chGoodchild/ups_switch/simulations/README.txt

Adding parts to LTSpice: https://www.youtube.com/watch?v=ajcYYwoHF0g

Finally we are thinking about using the TIP122
