chGoodchild/ups_switch/documents/dt90_specification.jpg

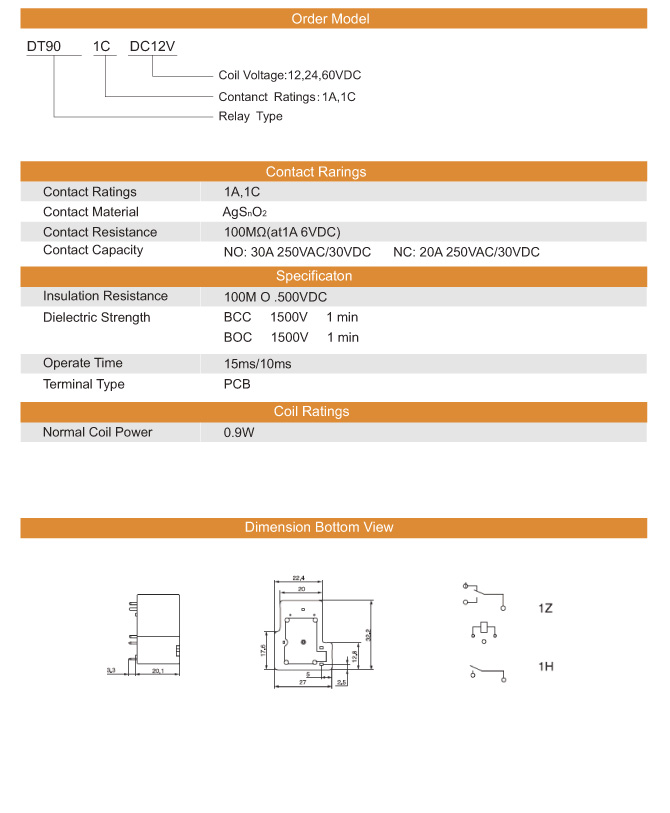
documents/dt90_specification.jpg
