chGoodchild/ups_switch/expenses.ods

Sheet: bill_materials
Common material |  |  |  |  |  | mod_switch_battery_voltage
Item | Model | Price | Qty. | Total | Comment | Item | Model | Price | Qty. | Total | Comment
Arduino Nano | Nano | 250 | 1 | 250 |  |  |  |  |  | 0
Resistors |  |  |  | 0 |  | Resistors |  | 1 | 4 | 4
 |  |  |  |  |  | Transistor | IRF540 | 25 | 1 | 25
 |  |  |  |  |  | Opto-isolator | PC817(B?) | 5 | 1 | 5
Headers | 3-pin |  |  | 0 |  | BrkWay Headers |  | 1 | 9 | 9
Headers | 2-pin |  |  | 0 |  | RMC Headers | 2-pin | 1 | 1 | 1
Headers | 15-pin |  | 0 | 0 | We don’t need to solder them on, only leave holes for them on the PCB, in case | LEDs |  | 2 | 1 | 2
 |  |  |  | 0 |  |  |  |  |  | 0
 |  |  |  | 0 |  |  |  |  |  | 0
 |  |  |  |  |  | Relay |  | 400 | 1 | 400
Diode | 1N4004 |  |  | 0 |  | Diode | 1N4004 | 1 | 2 | 2
Headers’ cables | 3-pin |  |  | 0 |  | Zener diode |  | 2 | 1 | 2
Headers’ cables | 2-pin |  |  | 0 |  | Headers’ cables | 2-pin | 10 | 1 | 10
 |  |  |  | 0 |  |  |  |  |  | 0
 |  |  |  | 0 |  |  |  |  |  | 0
 |  |  |  | 0 |  |  |  |  |  | 0
 |  |  |  | 0 |  |  |  |  |  | 0
 |  |  |  | 0 |  |  |  |  |  | 0
 |  |  |  | 0 |  |  |  |  |  | 0
 |  |  |  | 0 |  |  |  |  |  | 0
 |  |  |  | 0 |  |  |  |  |  | 0
PCB |  | 100 | 1 | 100 |  | PCB |  | 100 | 1 | 100
Soldering cost |  |  | 1 | 0 |  | Soldering cost |  | 75 | 1 | 75
Total |  |  |  | 350 |  | Total |  |  |  | 635
Total |  |  |  |  |  | Casing
Common material | 350 |  |  |  |  | Item | Model | Price | Qty. | Total | Comment
mod_switch_battery_voltage | 635 |  |  |  |  |  |  |  |  | 0
Casing | 64 |  |  |  |  |  |  |  |  | 0
Power supply part
Total | 1049 |  |  |  |  |  |  |  |  | 0
 |  |  |  |  |  |  |  |  |  | 0
 |  |  |  |  |  |  |  |  |  | 0
 |  |  |  |  |  | LEDs | Green? | 2 | 1 | 2
 |  |  |  |  |  | LEDs | Red? | 2 | 1 | 2
 |  |  |  |  |  |  |  |  |  | 0
 |  |  |  |  |  |  |  |  |  | 0
 |  |  |  |  |  |  |  |  |  | 0
 |  |  |  |  |  | Fuse holder | DC |  | 1 | 0
 |  |  |  |  |  | Battery cable set |  |  | 1 | 0
 |  |  |  |  |  | Switches |  |  |  | 0
 |  |  |  |  |  | Buttons |  |  |  | 0
 |  |  |  |  |  | 230 V AC socket |  |  | 1 | 0
 |  |  |  |  |  | 230 V AC plug |  | 60 | 1 | 60
 |  |  |  |  |  | 230 V AC power cord |  |  | 1 | 0
 |  |  |  |  |  | 230 V AC neon indicator? |  |  | 1 | 0
 |  |  |  |  |  |  |  |  |  | 0
 |  |  |  |  |  |  |  |  |  | 0
 |  |  |  |  |  | Total |  |  |  | 64

Sheet: shopping_list__bills
10K resistors |  | Bills |  | Dyuman | Chandran |  |  | Transfers |  |  | Debts
330 ohm resistors |  | A1-A11 | Naresh | ? |  |  |  | From | To | Amount | Chandran | Dyuman
4.7k resistors |  | A14,2xA16 | Naresh | 720 |  | 18/01/2018NA1 | Bill unmarked | Chandran | Dyuman | 800 | 970.105 | -970.105
100K resistors |  | A15,A19,A20 | Ganapathy | 90 |  |  |  | Chandran | Dyuman | 5201
1K resistors |  | 3xA16 | Universal | 750 |  | 18/01/2018UN1 | Bill unmarked | Chandran | Dyuman | 4500
diodes |  | 3xA24 | Naresh | 45 |  |  |  | Chandran | Dyuman (102659K - CARLA,SAURO DYUMAN) | 860
1.2M resistors |  | 10xA31 | Aurorica Circuits | 1000
2.2K resistors |  | 26/01/2018NA1 | Naresh | 467 |  | 26/01/2018NA1
2200p capacitor (ceramic) |  | A36 | Naresh | 45
100n capacitor (ceramic) |  | A39 | Sri Ganesh Kumaran Electricals |  | 174
22k resistors |  | A40 |  |  | 70
 |  | A32 | New Waves | 750
 |  | 3xA34 | Evelta | 669.1
schotkey diode |  | 10xA44 | Amazon | 715
opto isolator |  | 2xA16 | Naresh | 700 |  | 10/02/2018NA1
arduino |  | 2xA47 | eBay | 540
 |  | 2xA45 | Indica Computers | 340
opto isolator module |  | A47 | Deepak Electricals | 650
RS-232 connectors/cable/accessories |  | A48 | Suman Electricals | 230
560 ohm resistor |  | 100xA51:advance | Micro Track industries | 4000
IL2 9644J opto isolator |  | misc. Components between A53-A77 | Naresh | 495
breakaway header |  | 4xA55 | Ganapathy | 40
 |  | 10xA59 | eBay | 4000
IRF540 |  | 50xA57,50xA56 | RS components | 3142.93
resistor for above |  | A87 | eBay | 636 |  |  |  |  |  | 11361
Victor multimeter leads |  | A91 | Ganapathy
 |  | 1xA93,20xA53,10xA92 | Naresh | 170
Cordless phone batteries |  | A16 | Ganapathy |  | 380
Power bank |  | A84 | Kasthuri Emporium |  | 750
 |  | 100xA51:balance | Micro Track industries | 2490
PCB: mod_switch_battery_voltage |  | A85 |  |  | 25
Soldering: mod_switch_battery_voltage |  | A86 |  |  | 45
 |  | Main board soldering | New Waves |  | 1620
Current sensor |  | 2x5Vrelay | Ganapathy | 80
 |  | 230V coil 25A relay | Suman Electricals | 550
zener diode |  | 6x5V30Arelaymodules | eBay | 1618
RMC 2 pin |  | Heatsinks | Sun Electronics? |  | 220
 |  | fuses,fuseholders | Naresh |  | 97
Casing / 15A socket / buttons |  | 3xIRF540 | Universal | 80
Casing (box cutting) |  | 10x6Vrelay:advance | Naresh | 500
Phone repair? |  | 5x6Vrelay,8x9Vbattery,8x9Vbatcap | Ganapathy |  | 1150
Phone cover |  | Last School donation: CCTV camera |  | 1255
 |  | Last School donation: CCTV camera accessories |  | 55
DC-DC converter |  | Last School donation: 15A wall sockets |  | 422
USB cables |  | Voltage Regulators | RS components | 1948.18
Solid state relay + heatsink
Enclosure trial |  | Sub-total |  | 29193.21 | 4531
Enclosure trial |  | Sub-total (with transfers) |  | 17832.21 | 15892
 |  | Total |  |  | 33724.21
PCB: main_board
 |  | Expenses from before
RMC header 2-pin | 2 | DC-DC converter |  |  | Dyuman
RMC header 3-pin | 1 | Hot glue (1 stick)
breakaway header | 66
Fuse (F1) | 1
MCP1702 | 1
TIP122 | 1
display | 1 | Arduino list
arduino | 1 | 5 (18/01/2018NA1 and 18/01/2018UN1) | Chandran house | Burnt? | Breadboard | Class?
pushbutton | 3 | 2 (10/02/2018NA1) | LCD shield | Stored in desk
zener diode | 1 | 1 (found in clampmeter pouch, bought while before)
current sensor | 1
4.7k resistors | 1
330 ohm resistors | 1
Solid state relay + heatsink | 1
opto isolator | 1
44K resistor | 1
>10K | 1
C1 | 1
C2 | 1
capacitor (current sensor in) | 0
capacitor (current sensor out) | 0
Fuse (230 V, opto isolator) | 1
prototyping board | 0.1
RMC connectors 2-pin | 2
RMC connectors 3-pin | 1
battery cable (with lugs and fuse) | 1
fuse (battery cable) | 1
Casing | 1
mains socket/power cable/plug/screw terminals, depending on casing design | 1
circuit breaker for mains, or special fast acting fuse
Box
Notebook
Stapler
Solid state relay 100A
socket for arduino
opto isolator resistor divider
USB cable
drawers?
Heatsinks (with screws and washers/nuts)
Thermal paste
PCB: mains module
Relay | 1
Connector block | 4
Wire black/red
Diode 1N4004 | 2
PC817 | 1
IRF540 | 1
LM7805? | 1
47uF cap | 1
10uF cap | 1
breakaway header | 5
PC814 | 1
1.5M resistor | 1
10K? resistor (mosfet) | 1
6V zener? | 1
560? resistor (pc817) | 1
Lamp pwr adapters | 2

Sheet: Sheet3
Shops / Contacts
Aurorica | 9944956802
 | 9894025812
Interlogicx Solutions
PCB assembly services
Metro electronics | 9712336798
New waves | 9443090082
