chGoodchild/ups_switch/bat_tests/2019_06_12.png

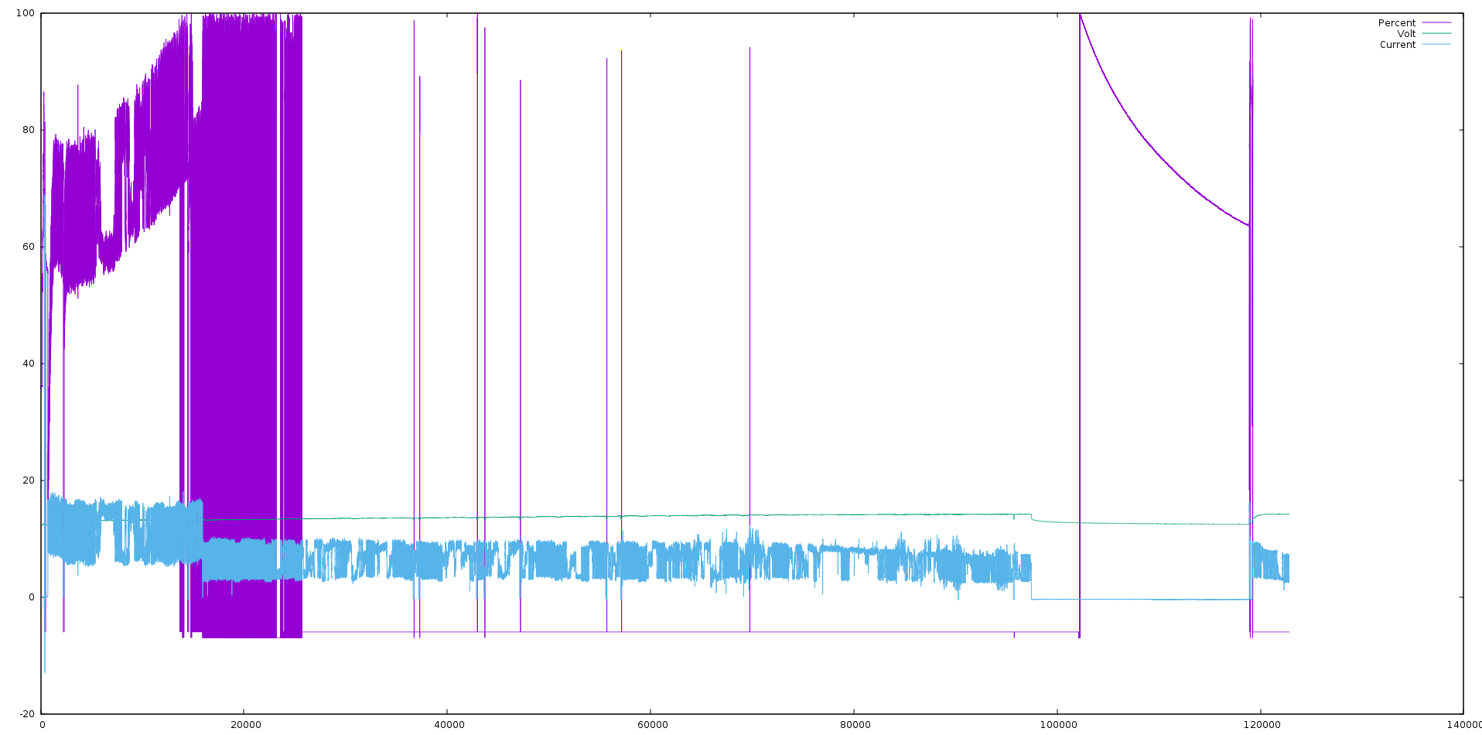
bat_tests/2019_06_12.png
