chGoodchild/ups_switch/bat_tests/2019_06_13.png

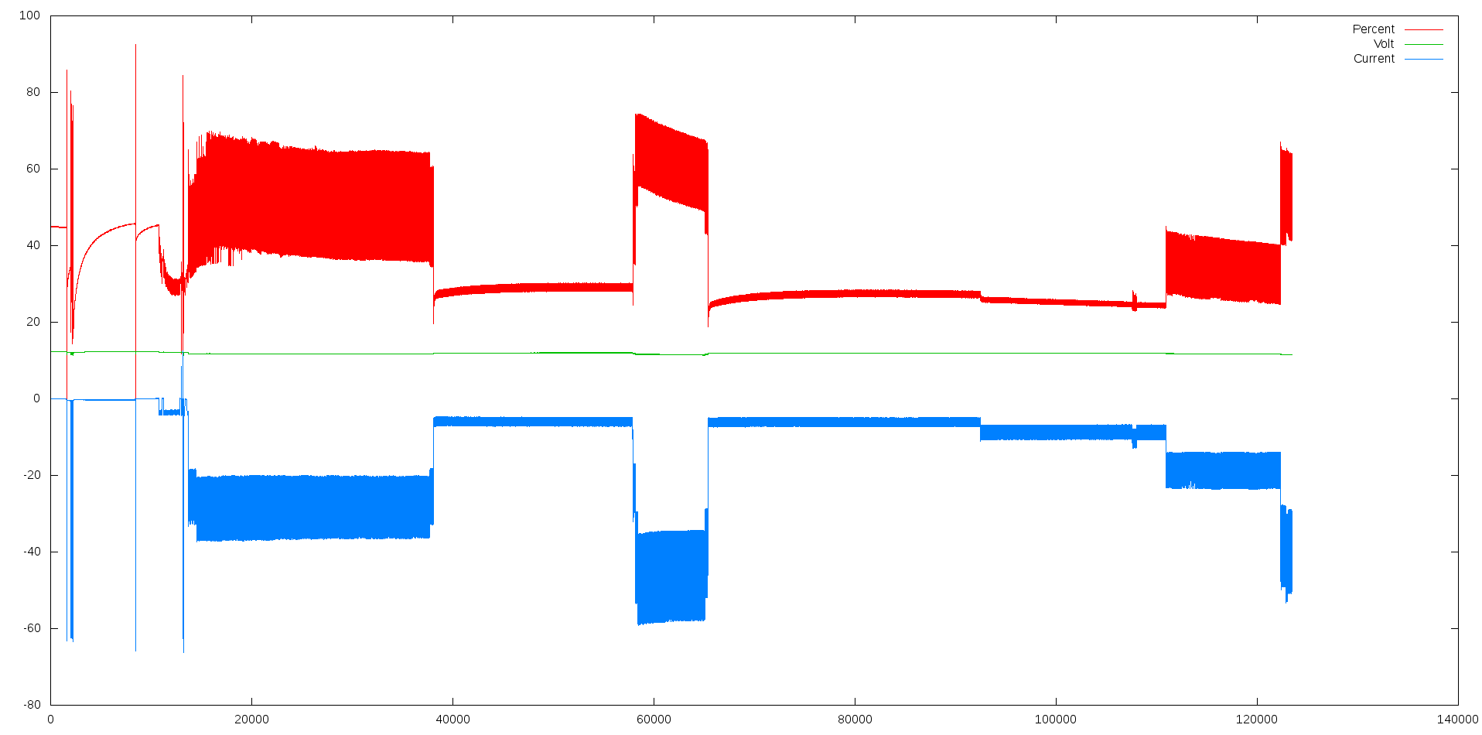
bat_tests/2019_06_13.png
