chGoodchild/ups_switch/bat_tests/2019_06_14.png

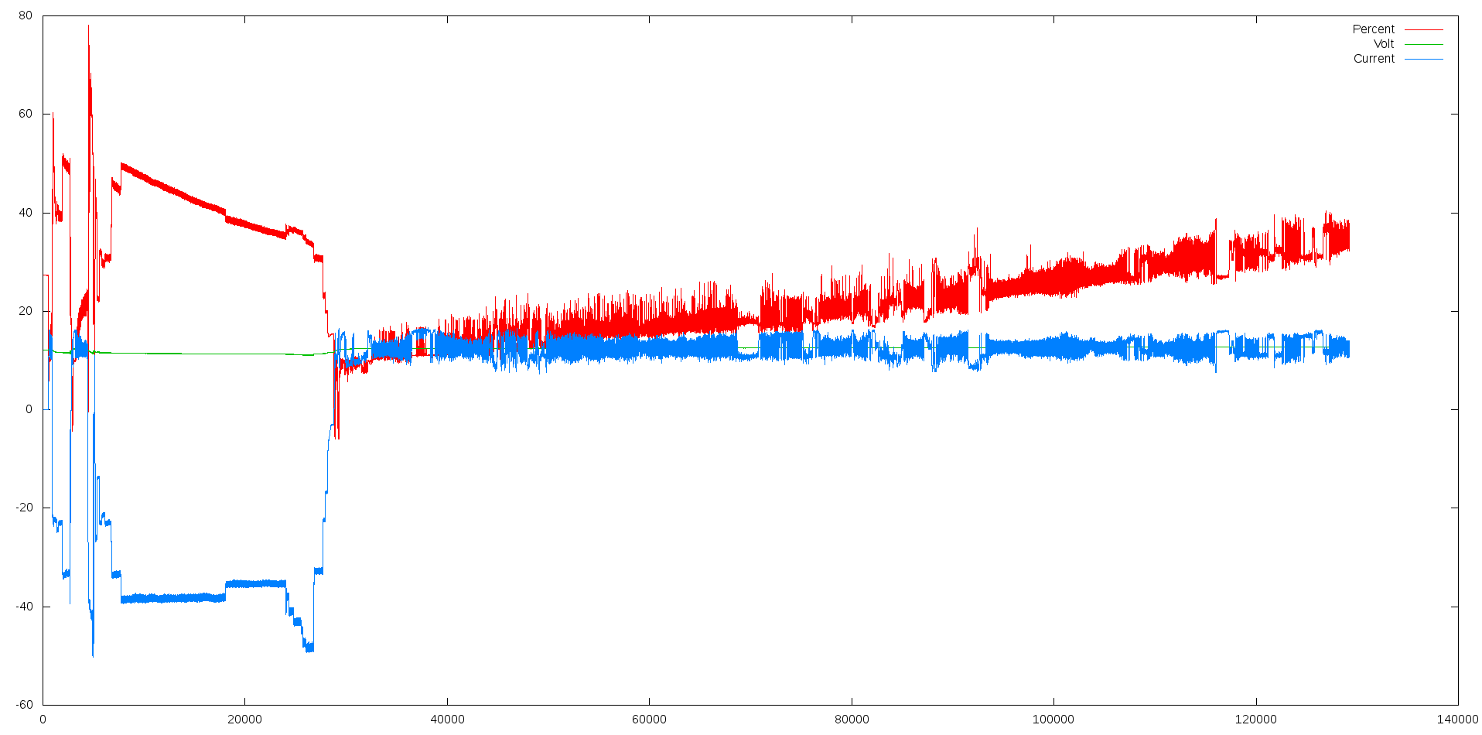
bat_tests/2019_06_14.png
