chGoodchild/ups_switch/bat_tests/2019_06_15.png

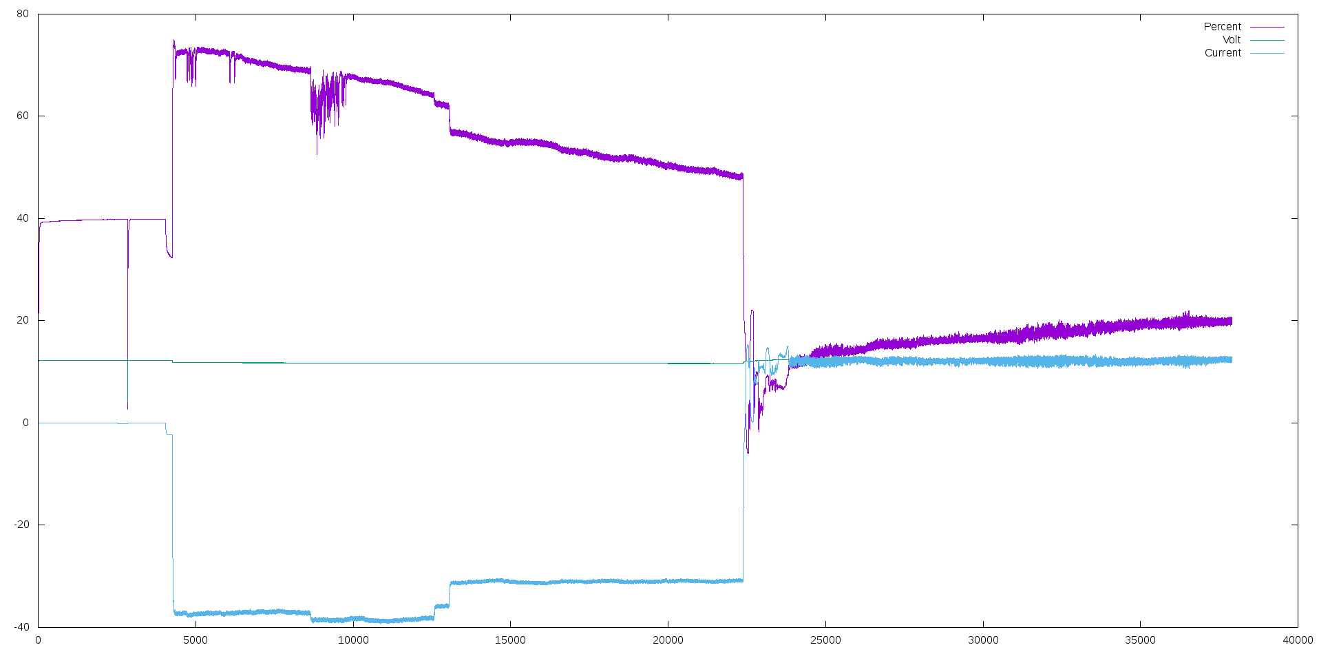
bat_tests/2019_06_15.png
