chGoodchild/ups_switch/archive/todo_list.ods

Add jumpers to separate arduino/etc. Power sources?
Merge DC-DC converter input and output headers into one so that when no converter is used (12V systems) placing a jumper is possible/enough?
Add possibility to provide 5V to Arduino
Add headers for direct tapping to Arduino pins
Add headers for LED indicators (Power/statusOK + Relay on)
Switches/butttons (manually on/off relay, reset, Arduino on/off). Headers necessary?
Add header for expansion? SPI?
Include protection diode on board PCB? i.e. in case it is missing on relay
Include reverse polarity protection diodes?
Verify package for TIP122
Verify package for resistors
Verify package for headers
Verify package for zener diode
Verify package for capacitor
Add polarized capacitor (after rectifier)
Verify zener diodes polarity
Verify PC817 polarities
Verify normal diodes polarity
Verify connect net segments near zener diode and normal diode
Verify connect net segments near PC817 -> ground, mains detector
Verify whether PC817 can work as “NPN” “PNP” or both
Verify whether we will use TIP122
Verify whether we will use opto-isolator
16A plug sufficient? Socket/plug appropriate?
Add circuitry to measure other DC voltages
Add circuitry to sense mains? Or just always power the relay from power adapter connected to TNEB?
Use fuse on mains input to mains sense circuit
Verify Arduino’s analog input max voltage (i.e. is 72V OpenCircuitVoltage ok?), and can we exceed 3.3V safely when AREF = 3.3V
Add reverse polarity protection on solar panel voltage input (one diode or two? 2-3 pin header? What about GND possibly common/not? Voltage can increase if polarity reversed. Study well situation. One more point?)
Add negative voltage protection on A1 (and A0?) verify correctness of how it’s in schematic
Add over voltage protection A0 and A1 (verify correctness of how it’s in schematic)
Verify that placing of resistors before (zener) diodes at analog inputs is good. And their value (10K?)
Is it a problem (probably not) that we read 4 V at panel input when panel input is 0? Could current be fed to the panel and/or damage resistor/zener/anything?
Sane to bond AREF to 3V3 on PCB?
ADC clock to improve accuracy?
AREF capacitor? pg. 244 of datasheet
resistor and/or capacitor at each analog input A0/A1? (datasheet)
Switching circuit opto-coupler active high/low possibilities
Switching circuit add headers for strength/attaching to mainboard (and connect to GND?)
Figure out simultaneous interrupts interfering (e.g. display)
