chGoodchild/ups_switch/(threads)

Thread 1 (2018-02-03):

Vref is 3.6 V instead of 3.3 V

chGoodchild, 2018-02-03:
Vref is 3.6 V instead of 3.3 V

One possible solution would be to disconnect the 3.3 V source from Aref, measure the actual voltage of our 3.3 V source and connect the 3.3 V source to Aref using the measured voltage as Vref.

We can add a transistor to the motherboard to connect Aref with the 3.3 V source

chGoodchild, 2018-03-14:
We are using a precisely regulated 5 volt source now...

Closed 2018-03-14.

Thread 2 (2018-02-07):

Interrupts + interrupt timer

chGoodchild, 2018-02-07:
We do the battery voltage measurement and the current measurement with interrupt timers so that they happen at regular intervals regardless of the other code (thus allowing for a more controlled moving average)...

Here is some example code for interrupts:
https://playground.arduino.cc/Deutsch/HalloWeltMitInterruptUndTimerlibrary

chGoodchild, 2018-05-12:
That's what we are planning to do. We still have to find the flow chart though...

Closed 2018-05-12.

Thread 3 (2018-02-07):

Logging

chGoodchild, 2018-02-07:
There are two options for logging:
1. We use the eeeprom of our arduino and we store information whenever the state of the switch changes (or other interesting events occur)...
2. We would temporarily use serial print and a raspberry PI

chGoodchild, 2018-02-07:
The eeprom seems easy to use: https://www.norwegiancreations.com/2017/02/using-eeprom-to-store-data-on-the-arduino/

We can use [#ifdef](https://github.com/chGoodchild/ups_switch/issues/5) to print the contents of the eeprom to the serial terminal, because it doesn't get overwritten when the arduino is reprogrammed: http://forum.arduino.cc/index.php?topic=3831.0

Thread 4 (2018-02-07):

Current measurement

chGoodchild, 2018-02-07:
We have sources of inaccuracy and sources of imprecision: http://msclantonsphysicalsciencepage.weebly.com/uploads/6/4/7/0/6470542/6786386_orig.jpg

Inaccuracy:
* The Aref problem, see: https://github.com/chGoodchild/ups_switch/issues/1
* The output of the current sensor at zero current must be known in order to determine the current. Thus a switch or access to the eeeprom might be needed.

Imprecision:
* Noise
* The ADC error of 2 LSB ---> 4 / 1024 ---> approx 0,39%

chGoodchild, 2018-05-12:
The most significant error comes from the percentage function

Thread 6 (2018-02-07):

Test and document the switching module

chGoodchild, 2018-02-07:
We should extensively test and document the switching module.

It would be nice to make an [eye diagram](https://www.testandmeasurementtips.com/basics-eye-diagrams/) at various frequencies and loads.

chGoodchild, 2018-03-14:
We are no longer using the switching module. Instead we are planning to use solid state relays that can be driven with as little as 3 volts

chGoodchild, 2018-05-12:
We are no longer using the switching module. Such data throughput is anyway not necessary for our purposes..

Closed 2018-05-12.

Thread 7 (2018-02-07):

Lead acid battery charging characteristics

chGoodchild, 2018-02-07:
This document nicely describes the charging characteristics of a lead acid battery: https://scubaengineer.com/documents/lead_acid_battery_charging_graphs.pdf

We need the function that describes that curve in order to figure out the current charge of the battery.

We can either try to collect such data and fit a curve onto it or we can try to fit a curve onto their data or we can try to find a function somewhere on the internet.

chGoodchild, 2018-02-07:
Off course we still have coulomb counting (when the offset is accounted for)
http://batteryuniversity.com/learn/article/how_to_measure_state_of_charge

chGoodchild, 2018-05-12:
We implemented the function, but not coulomb counting

Closed 2018-05-12.

Thread 8 (2018-02-07):

Possible uses of eeprom

chGoodchild, 2018-02-07:
* Store the maximum capacity of the battery
* Store the "zero current" value (getting this value without switching is still a problem)...
* Use for logging

chGoodchild, 2018-05-12:
this is also in the latest version of the flowchart

Closed 2018-05-12.

Thread 9 (2018-03-14):

Switching module ground pin

chGoodchild, 2018-03-14:
If there is a loose connection on the ground pin of our switching module, we get the battery voltage directly at the output of the voltage divider. This is not acceptable for the Arduino...

chGoodchild, 2018-05-12:
We are no longer using the switching module

Closed 2018-05-12.

Thread 10 (2018-05-12):

Milli second counter overflow ---> negative times...

chGoodchild, 2018-05-12:
Milli second counter overflow too large.

create one variable for milliseconds and one half minutes (30 seconds). We don't do seconds and full minutes, because we want to save space on the micro controller...

Limitations:
Our 1/2 minutes overflow after about 11 days.

Thread 12 (2018-05-12):

Boundary variable for -3 error

chGoodchild, 2018-05-12:
I have to use variables for setting the -3 error.

The -3 error should not be used to override the percentage function. We will add a dedicated voltage limit...

Thread 13 (2018-05-12):

Create a dedicated error message for lower bound voltage boundary

chGoodchild, 2018-05-12:
Create a dedicated error message for lower bound voltage boundary.

The rough code already has a variable for this...

Thread 14 (2018-10-04):

Power supply

chGoodchild, 2018-10-04:
We need to be able to handle higher voltages.

TI released a new buck IC: http://www.ti.com/lit/ds/symlink/lm5161-q1.pdf

Either we wait for buck modules to be sold in the arduino scene or we add the IC to the next version of our module. Whichever comes first...
