chGoodchild/ups_switch/eagle/mains_module/mains_module_black.pdf

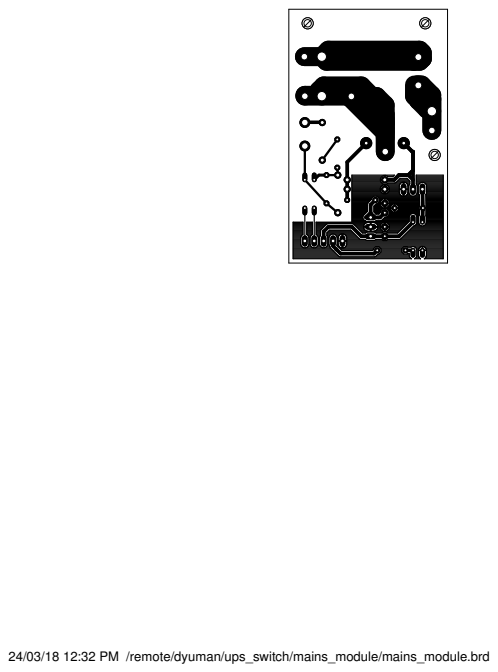
[picture p14: page 1]

24/03/18 12:32 PM /remote/dyuman/ups_switch/mains_module/mains_module.brd
