chGoodchild/ups_switch/eagle/mains_module/mains_module_full.pdf

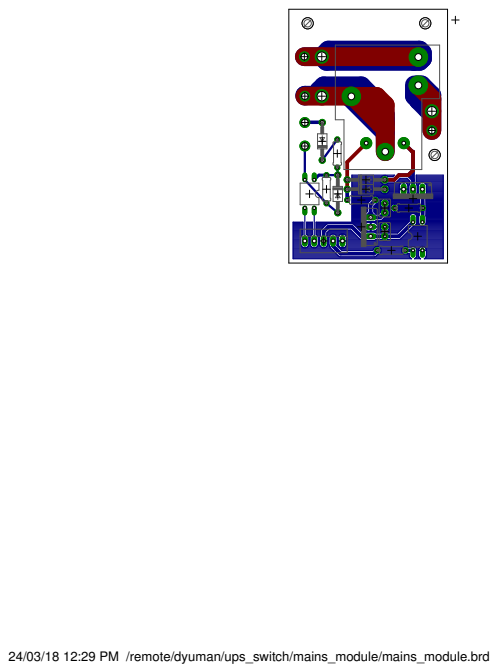
[picture p15: page 1]

24/03/18 12:29 PM /remote/dyuman/ups_switch/mains_module/mains_module.brd
