chGoodchild/ups_switch/eagle/solar_mains_charge_manager/solar_mains_charge_manager.pdf

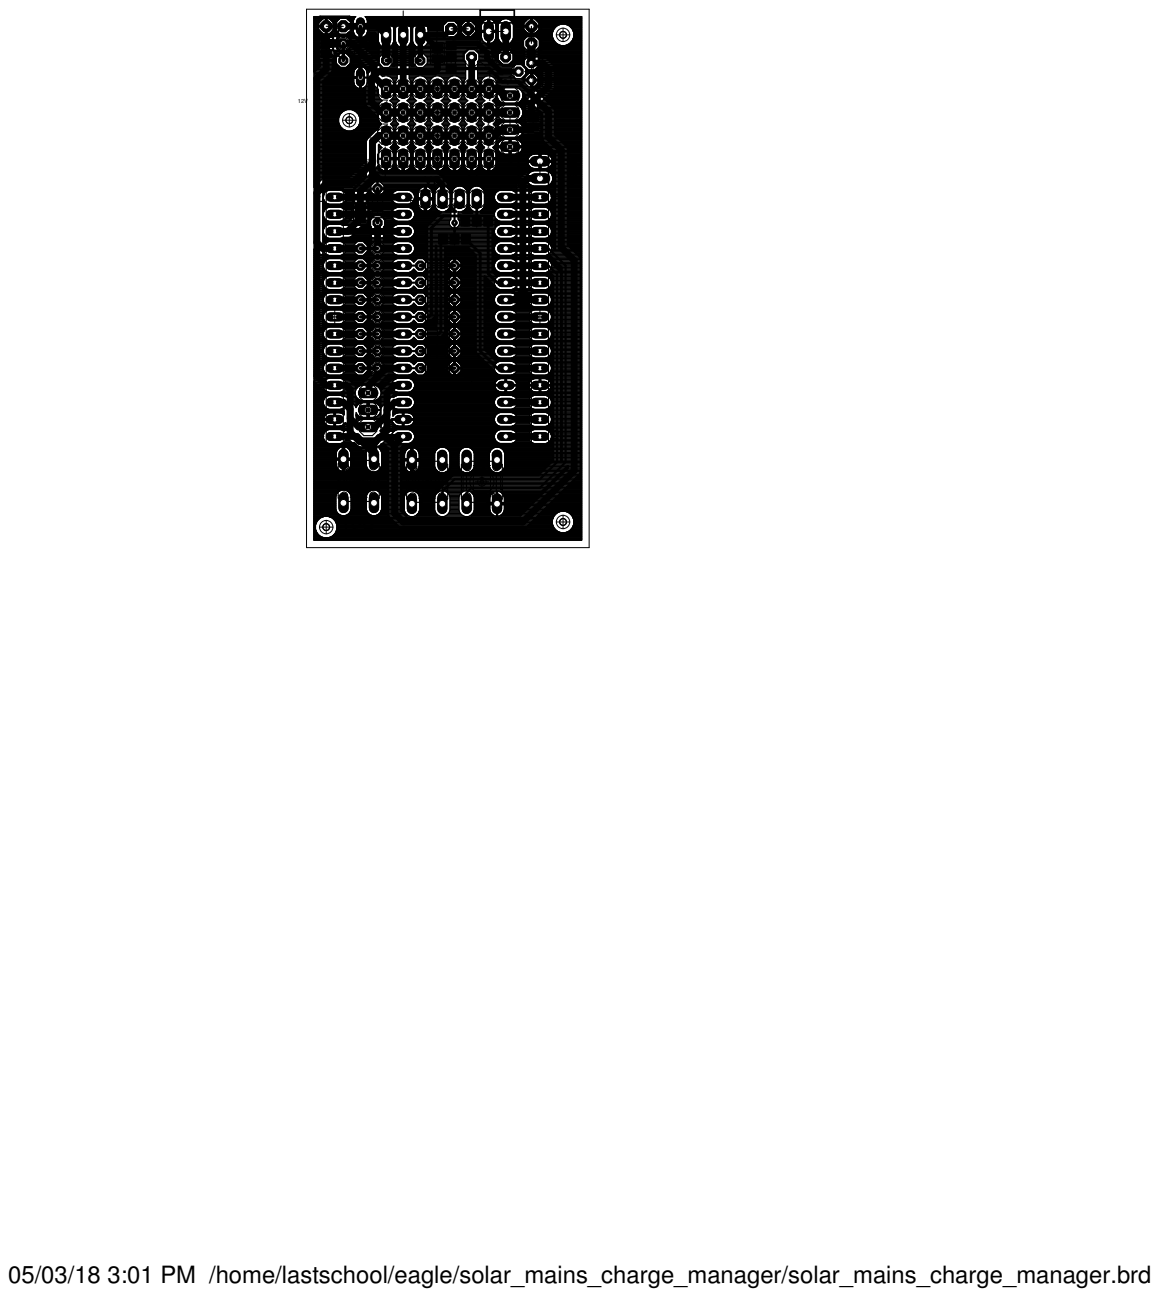
[picture p16: page 1]

05/03/18 3:01 PM /home/lastschool/eagle/solar_mains_charge_manager/solar_mains_charge_manager.brd
