chGoodchild/ups_switch/eagle/mod_switch_battery_voltage/mod_switch_battery_voltage1.pdf

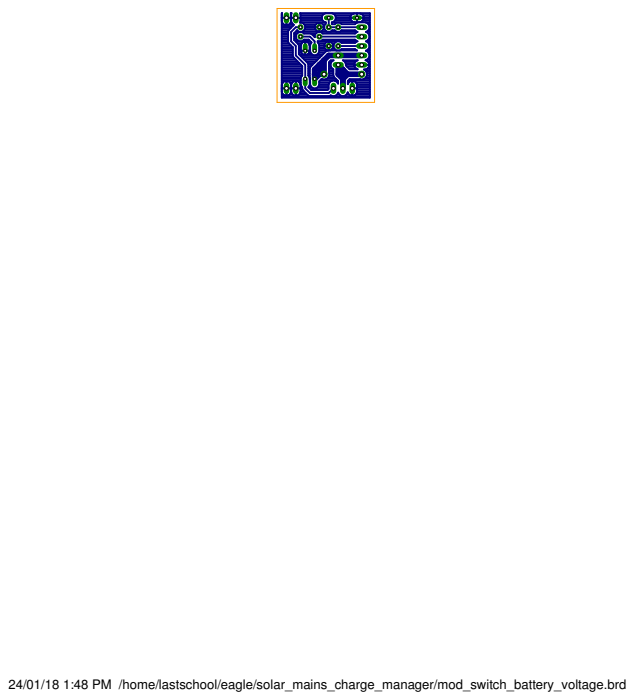
[picture p18: page 1]

24/01/18 1:48 PM /home/lastschool/eagle/solar_mains_charge_manager/mod_switch_battery_voltage.brd
