chGoodchild/ups_switch/eagle/mod_switch_battery_voltage/mod_switch_battery_voltage_black_white.pdf

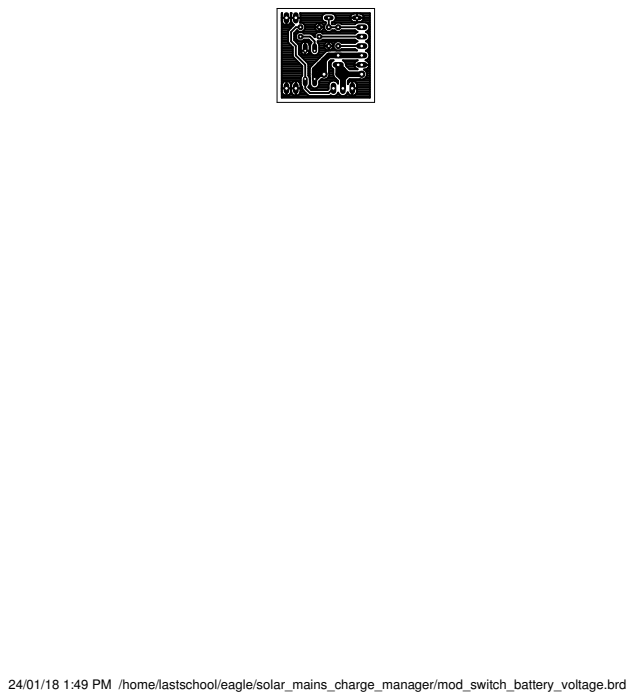
[picture p19: page 1]

24/01/18 1:49 PM /home/lastschool/eagle/solar_mains_charge_manager/mod_switch_battery_voltage.brd
