chGoodchild/ups_switch/simulations/12V_npn_only_bipolar.asc

C1: cap; 10mu
D1: zener; EDZV12B
Q1: npn
Q2: npn
R1: res; 1R
R3: res; 10k
V1: voltage; 100
Named nets: 0
.tran 1000
