chGoodchild/ups_switch/simulations/10_V_source.asc

C2: cap; 10µ
D1: zener; EDZV12B
M1: nmos; IRF530
Q1: npn; 2N5550
R1: res; 100k
R2: res; 10k
R3: res; 100k
V1: voltage; 100
Named nets: 0
.tran 1000
