chGoodchild/ups_switch/simulations/12_V_source_pchannel.asc

C2: cap; 10µ
D1: zener; PTZ12B
M1: pmos; RSQ015P10
R1: res; 1k
V1: voltage; 100
Named nets: 0
.tran 1000
