chGoodchild/ups_switch/eagle/mod_panel_voltage/mod_panel_voltage.brd

## EAGLE design eagle/mod_panel_voltage/mod_panel_voltage.brd (2018-01-26)

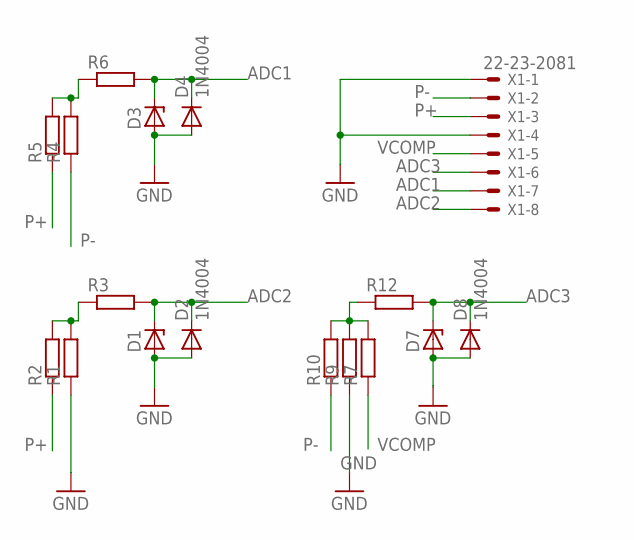
[picture p20: schematic mod_panel_voltage.sch]

Parts:
D1, D3, D7: ZENER-DIODEDO34-7; DO34Z7
D2, D4, D8: 1N4004; DO41-10
R1, R2, R3, R4, R5, R6, R7, R9, R10, R12: R-EU_0204/5; 0204/5
X1: 22-23-2081

Connections:
ADC1: D3.C, D4.C, R6.2, X1.7
ADC2: D1.C, D2.C, R3.2, X1.8
ADC3: D7.C, D8.C, R12.2, X1.6
GND: D1.A, D2.A, D3.A, D4.A, D7.A, D8.A, R1.1, R9.1, X1.1, X1.4
unnamed: R7.2, R9.2, R10.2, R12.1
unnamed: R1.2, R2.2, R3.1
unnamed: R4.2, R5.2, R6.1
P+: R2.1, R5.1, X1.3
P-: R4.1, R10.1, X1.2
VCOMP: R7.1, X1.5

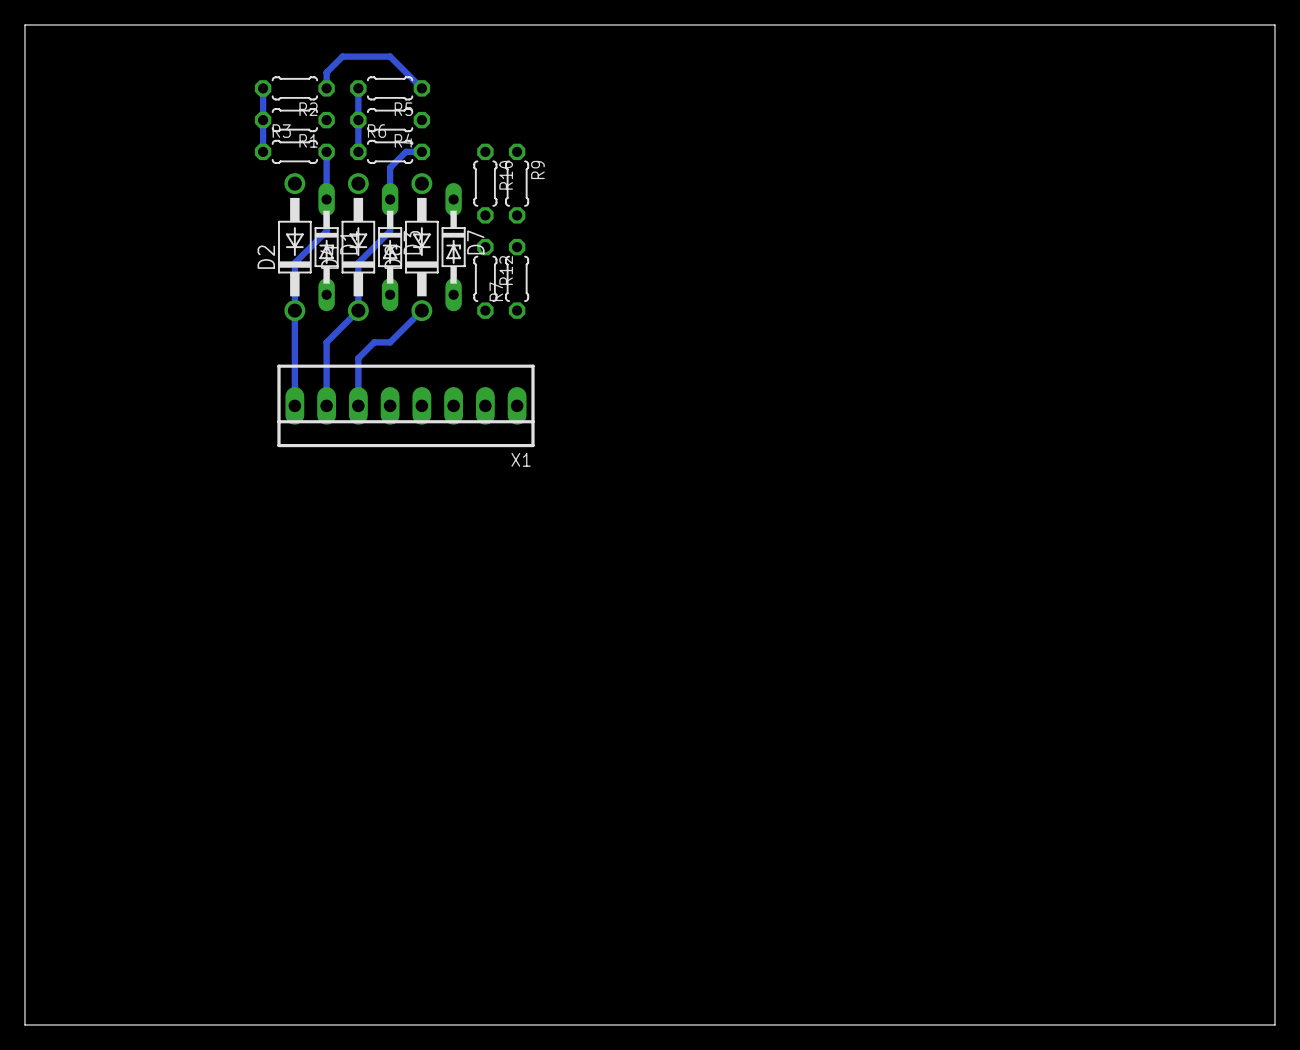
[picture p21: board mod_panel_voltage.brd from above]

Board: 2 copper layers, 100.0 x 80.0 mm, 17 parts (0 on the bottom side), 10 nets.
