chGoodchild/ups_switch/eagle/mod_switch_battery_voltage/mod_switch_battery_voltage.brd

## EAGLE design eagle/mod_switch_battery_voltage/mod_switch_battery_voltage.brd (2018-01-26)

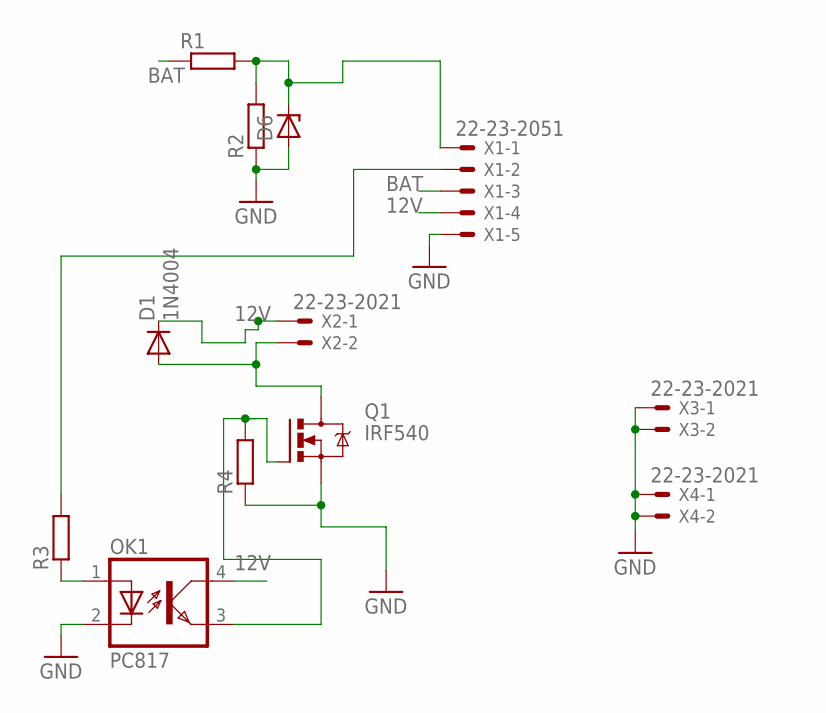
[picture p22: schematic mod_switch_battery_voltage.sch]

Parts:
D1: 1N4004; DO41-10
D6: ZENER-DIODEDO34-7; DO34Z7
OK1: PC817; DIL04
Q1: IRF540; TO220BV
R1, R2, R3, R4: R-EU_0204/5; 0204/5
X1: 22-23-2051
X2, X3, X4: 22-23-2021

Connections:
12V: D1.C, OK1.4 (COL), X1.4, X2.1
BAT: R1.1, X1.3
GND: D6.A, OK1.2 (C), Q1.S, R2.1, R4.1, X1.5, X3.1, X3.2, X4.1, X4.2
unnamed: OK1.1 (A), R3.1
unnamed: D1.A, Q1.D, X2.2
unnamed: R3.2, X1.2
unnamed: OK1.3 (EMIT), Q1.G, R4.2
unnamed: D6.C, R1.2, R2.2, X1.1

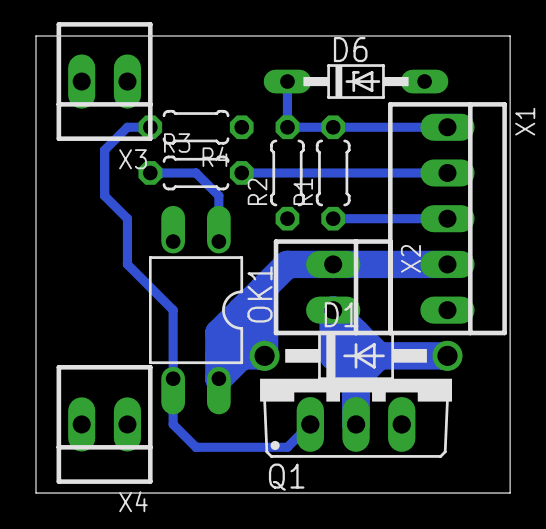
[picture p23: board mod_switch_battery_voltage.brd from above]

Board: 2 copper layers, 26.3 x 25.4 mm, 12 parts (0 on the bottom side), 8 nets.
