chGoodchild/ups_switch/eagle/solar_mains_charge_manager/solar_mains_charge_manager.brd

## EAGLE design eagle/solar_mains_charge_manager/solar_mains_charge_manager.brd (2018-03-03)

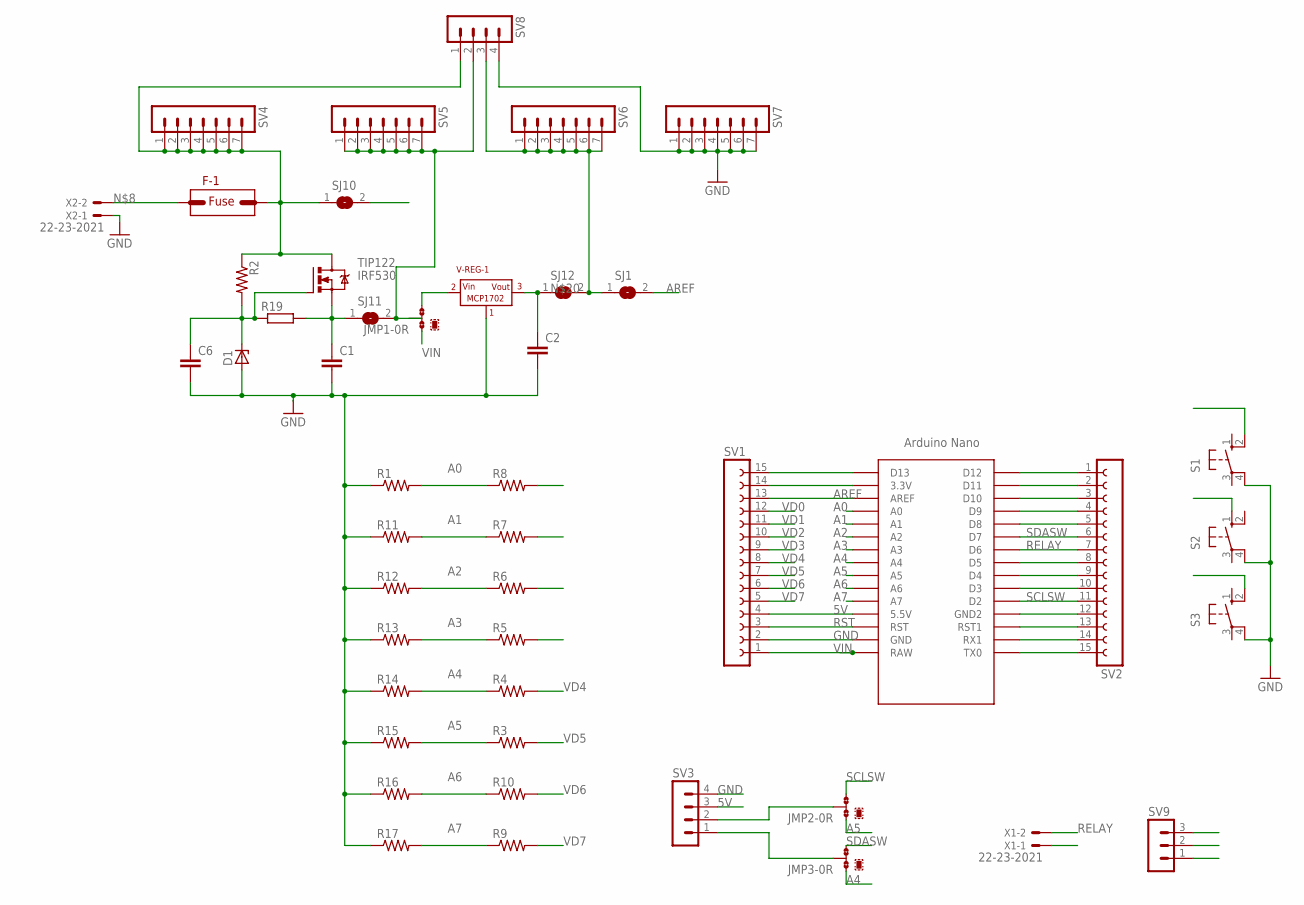
[picture p24: schematic solar_mains_charge_manager.sch]

Parts:
C1, C2, C6: C2,5-3; C2.5-3
D1: ZENER-DIODEDO34-7; DO34Z7
F-1: FUSE
JMP1, JMP2, JMP3: 0R-JUMPA; A0R-JMP
R1, R11, R12, R13, R14, R15, R16, R17: R-US_0204/5; 0204/5
R2, R3, R4, R5, R6, R7, R8, R9, R10: R-US_0204/2V; 0204V
R19: R-EU_0204/5; 0204/5
S1, S2, S3: 10-XX; B3F-10XX
SJ1, SJ10, SJ11, SJ12: SJ
SV1, SV2: FE15-1; FE15
SV3, SV8: MA04-1
SV4, SV5, SV6, SV7: MA07-1
SV9: MA03-1
TIP122: IRF530; TO220BV
U$1: NANO
V-REG-1: MCP1702; TO92
X1, X2: 22-23-2021

Connections:
5V: SJ1.1, SJ12.2, SV1.4, SV3.3, SV6.1, SV6.2, SV6.3, SV6.4, SV6.5, SV6.6, SV6.7, SV8.3, SV9.3, U$1.5V (5.5V)
A0: R1.2, R8.1, U$1.A0
A1: R7.1, R11.2, U$1.A1
A2: R6.1, R12.2, U$1.A2
A3: R5.1, R13.2, U$1.A3
A4: JMP3.1, R4.1, R14.2, U$1.A4
A5: JMP2.1, R3.1, R15.2, U$1.A5
A6: R10.1, R16.2, U$1.A6
A7: R9.1, R17.2, SV9.1, U$1.A7
AREF: SJ1.2, SV1.13, U$1.AREF
BAT: F-1.P$2, R2.1, SJ10.1, SV4.1, SV4.2, SV4.3, SV4.4, SV4.5, SV4.6, SV4.7, SV8.1, TIP122.D
D8: S2.1 (S), SV2.5, U$1.D8
D9: S1.2 (S1), SV2.4, U$1.D9
GND: C1.2, C2.2, C6.2, D1.A, R1.1, R11.1, R12.1, R13.1, R14.1, R15.1, R16.1, R17.1, S1.4 (P1), S2.4 (P1), S3.4 (P1), SV1.2, SV2.12, SV3.4, SV7.1, SV7.2, SV7.3, SV7.4, SV7.5, SV7.6, SV7.7, SV8.4, SV9.2, U$1.GND, U$1.GND1 (GND2), V-REG-1.1, X1.1, X2.1
unnamed: C1.1, R19.2, SJ11.1, TIP122.S
unnamed: SV1.15, U$1.D13
unnamed: C6.1, D1.C, R2.2, R19.1, TIP122.G
unnamed: SV2.1, U$1.D12
unnamed: SV1.14, U$1.3.3V
unnamed: JMP1.3, V-REG-1.2
unnamed: SV2.2, U$1.D11
unnamed: F-1.P$1, X2.2
unnamed: JMP2.2, SV3.2
unnamed: JMP3.2, SV3.1
unnamed: SV2.3, U$1.D10
unnamed: C2.1, SJ12.1, V-REG-1.3
unnamed: JMP1.2, SJ11.2, SV5.1, SV5.2, SV5.3, SV5.4, SV5.5, SV5.6, SV5.7, SV8.2
unnamed: SV2.8, U$1.D5
unnamed: SV2.9, U$1.D4
unnamed: SV2.10, U$1.D3
unnamed: SV2.13, U$1.RST1
unnamed: SV2.14, U$1.RX1
unnamed: SV2.15, U$1.TX0
RELAY: SV2.7, U$1.D6, X1.2
RST: S3.2 (S1), SV1.3, U$1.RST
SCLSW: JMP2.3, SV2.11, U$1.D2
SDASW: JMP3.3, SV2.6, U$1.D7
VD0: R8.2, SJ10.2, SV1.12
VD1: R7.2, SV1.11
VD2: R6.2, SV1.10
VD3: R5.2, SV1.9
VD4: R4.2, SV1.8
VD5: R3.2, SV1.7
VD6: R10.2, SV1.6
VD7: R9.2, SV1.5
VIN: JMP1.1, SV1.1, U$1.RAW

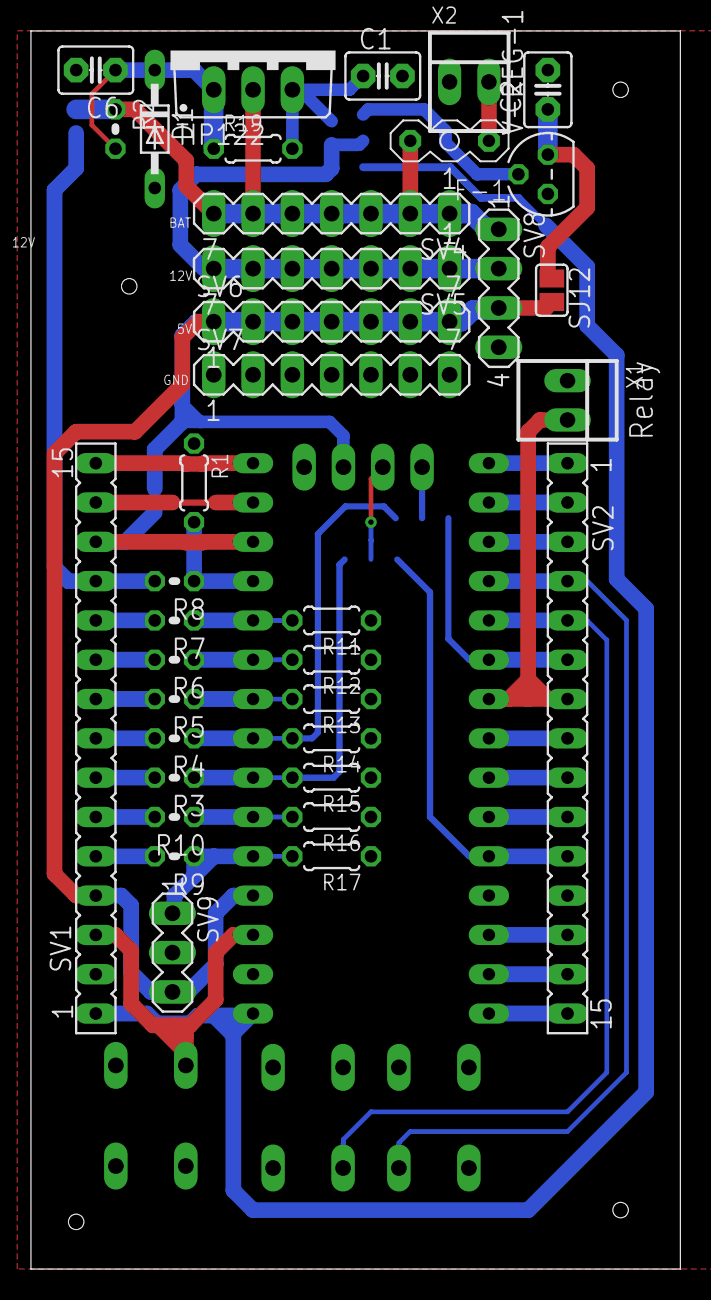
[picture p25: board solar_mains_charge_manager.brd from above]

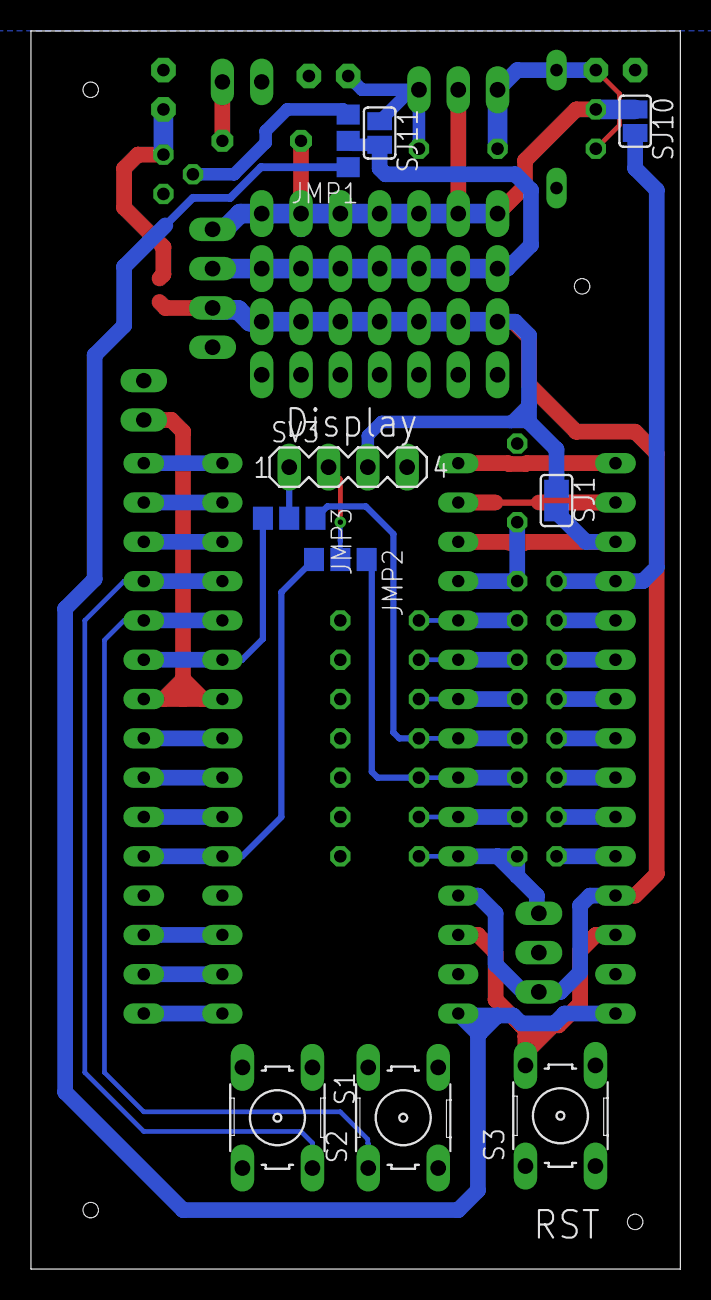
[picture p26: board solar_mains_charge_manager.brd from below]

Board: 2 copper layers, 42.0 x 80.0 mm, 47 parts (10 on the bottom side), 46 nets.
