chGoodchild/ups_switch/eagle/mains_module/mains_module.brd

## EAGLE design eagle/mains_module/mains_module.brd (2018-04-21)

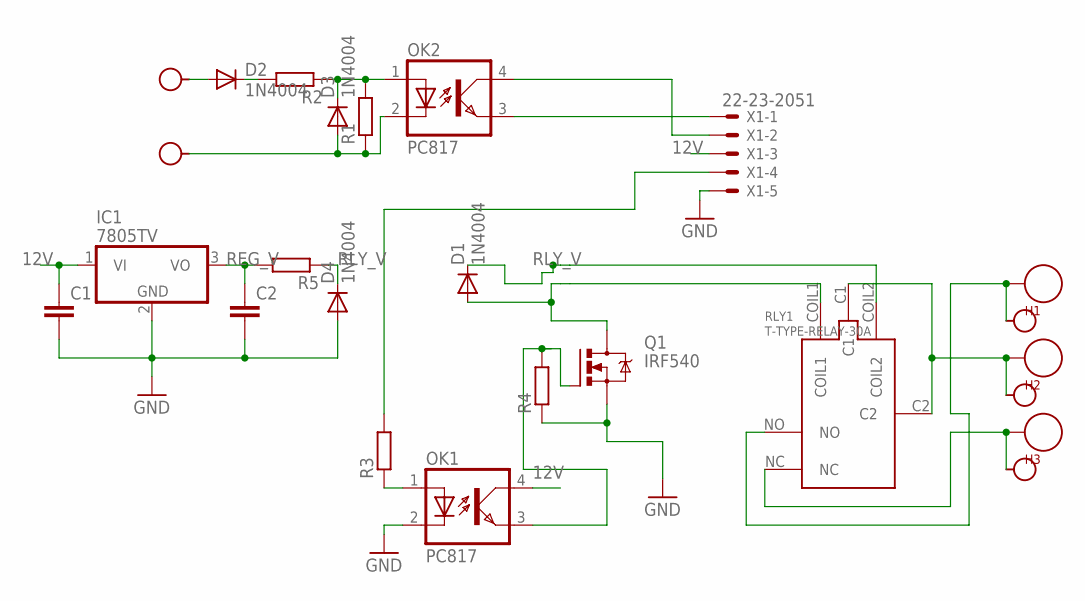
[picture p27: schematic mains_module.sch]

Parts:
C1, C2: C2,5-3; C2.5-3
D1, D2, D3, D4: 1N4004; DO41-10
H1, H2, H3: SEW_HOLE; SIMPLE_HOLE
H4, H5, H6, H7, H8: SEW_HOLE-SMALL; SIMPLE_HOLE_SM
IC1: 7805TV; TO220V
OK1, OK2: PC817; DIL04
Q1: IRF540; TO220BV
R1, R2, R3, R4, R5: R-EU_0207/7; 0207/7
RLY1: T-TYPE-RELAY-30A
X1: 22-23-2051

Connections:
12V: C1.1, IC1.1 (VI), OK1.4 (COL), X1.3
GND: C1.2, C2.2, D4.A, IC1.2 (GND), OK1.2 (C), Q1.S, R4.1, X1.5
unnamed: OK2.3 (EMIT), X1.1
unnamed: OK2.4 (COL), X1.2
unnamed: H1.P$1, H4.P$1, RLY1.NO
unnamed: OK1.1 (A), R3.1
unnamed: D1.A, Q1.D, RLY1.COIL1
unnamed: R3.2, X1.4
unnamed: OK1.3 (EMIT), Q1.G, R4.2
unnamed: D2.C, R2.2
unnamed: H3.P$1, H6.P$1, RLY1.NC
unnamed: D2.A, H8.P$1
unnamed: D3.C, OK2.1 (A), R1.2, R2.1
unnamed: D3.A, H7.P$1, OK2.2 (C), R1.1
unnamed: H2.P$1, H5.P$1, RLY1.C1, RLY1.C2
REG_V: C2.1, IC1.3 (VO), R5.2
RLY_V: D1.C, D4.C, R5.1, RLY1.COIL2

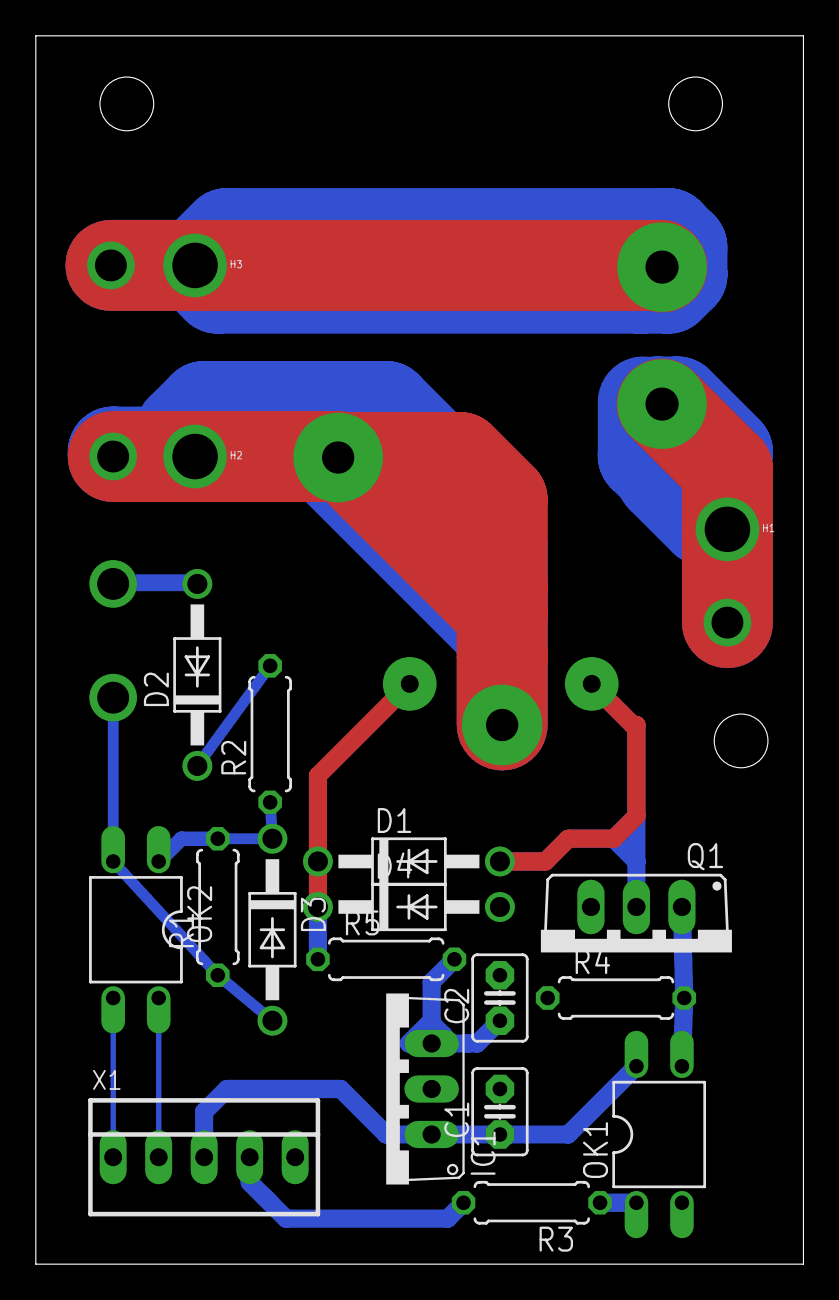
[picture p28: board mains_module.brd from above]

Board: 2 copper layers, 42.9 x 68.6 mm, 25 parts (0 on the bottom side), 17 nets.
