chGoodchild/ups_switch/code/version_1.0/MULTIMETER.h

#ifndef MULT
#define MULT
     
#include <Arduino.h>
     
class MULTIMETER {

// Global variables
float measurements[4]; // @@@ maybe variables should be initialized to 0? they are in .cpp file
float capacity;
float calib;
int error;

 public:
  MULTIMETER(); // @@@ remove this argument
  ~MULTIMETER(); // @@@ what is this?
  void calibration();
  void reCalibrate();
  void initialize(float C);
  float batteryVoltage();
  void measure();
  float currentInAmps();
  float getPercentage();
  float getV();
  float getI();
  float getMeasuredV();
  float getError();
  float percentage (float U, float I, float C);
};

#endif
