chGoodchild/ups_switch/(commit log)

2018-01-10 Added stuff, it's still a mess, will re-organize
    [psu_considerations.ods, solar_mains_charge_manager.brd, solar_mains_charge_manager.sch]
2018-01-10 Some more schematic and spreadsheet
    [psu_considerations.ods, solar_mains_charge_manager.sch]
2018-01-10 Deleted corrupted eagle schematic file. After having opened psu_considerations.ods in LibreOffice, git detects as if there were changes in it (actually there weren't)
    [psu_considerations.ods, solar_mains_charge_manager.sch]
2018-01-11 Updated calculation solar panel plot in psu_considerations.ods
    [psu_considerations.ods]
2018-01-11 psu_considerations: added functions to easily switch between plots for different system voltages and conditional formatting to highlight voltages out of bounds
    [psu_considerations.ods]
2018-01-11 Added solar panel voltage measurement along with over voltage and negative voltage protection in schematic, plus comments on the same in psu_considerations.ods
    [psu_considerations.ods, solar_mains_charge_manager.brd, solar_mains_charge_manager.sch]
2018-01-11 Continued work on adding overvoltage protection on analog inputs and measurement of solar panel voltage
    [psu_considerations.ods, solar_mains_charge_manager.brd, solar_mains_charge_manager.sch]
2018-01-12 Continued work on solar panel voltage measurement, added code to read analog input and calculate voltage, with hard-coded (for now) battery voltage and temporarily reading A0
    [psu_considerations.ods]
2018-01-14 psu_considerations.ods: started preparing list of definable settings for program
    [psu_considerations.ods]
2018-01-16 psu_considerations.ods: worked on panel voltage plot
    [psu_considerations.ods]
2018-01-22 A lot of stuff
    [mod_mains_presence.sch, mod_panel_voltage.sch, mod_switch_battery_voltage.brd, mod_switch_battery_voltage.sch, psu_considerations.ods, solar_mains_charge_manager.brd, solar_mains_charge_manager.sch]
2018-01-26 Finished board layout of mod_switch_battery_voltage and more work on psu_considerations.ods
    [mod_panel_voltage.brd, mod_panel_voltage.sch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]
2018-01-27 psu_considerations.ods: added possible modules list sheet
    [psu_considerations.ods]
2018-02-02 psu_considerations.ods: misc. notes
    [psu_considerations.ods]
2018-02-03 psu_considerations.ods: misc. updates. Fixed code to switch on and off at 23.4 / 26, and print relay status on USB
    [psu_considerations.ods]
2018-02-07 Percentage charge of the battery
    We should soon find a function that describes the batteries behavior in order to better understand it...
    https://scubaengineer.com/dndocuments/lead_acid_battery_charging_graphs.pdf
2018-02-09 Large due to voltage offset.
2018-02-09 We still have an offset. Maybe the sensor isn't providing enough current?
2018-03-03 Added a function for checking the battery state, but it has not been tested yet...
2018-03-03 Corrected currents and charge time
    [arduino_implementation.ino]
2018-03-05 My first attempt ant limiting the range of the functions. A lot of potential problems were fixed...
    [arduino_implementation.ino]
2018-03-14 Tested the function with scaling and it seems to be working, but I need a moving average because of the crazy input from the battery charger...
2018-03-18 Display values on display home screen
    [solar_mains_charge_manager.sch]
2018-03-18 With MCP1702 voltage refference
2018-03-19 Misc. small changes
    [psu_considerations.ods]
2018-03-22 Added relay purchase advance in expense list
    [psu_considerations.ods]
2018-03-22 Started work on mains_module
    [mains_module.brd, mains_module.sch]
2018-03-23 Worked on relay and updated expences
    [psu_considerations.ods]
2018-03-24 Completed T-type-relay eagle part, created schematic and board of mains_module, and updates to shopping list/expense list
    [mains_module.sch, psu_considerations.ods]
2018-04-21 Tidied up and renamed the battery percentage function / folder
2018-04-21 Cleanup 1
    [mains_module.brd, mains_module.sch]
2018-04-21 Cleanup 2
    [mod_mains_presence.sch, mod_panel_voltage.brd, mod_panel_voltage.sch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]
2018-04-21 board improvements
2018-04-21 Cleanup 6
    [expenses.ods, panel_voltage_plot.ods, possible_modules_list.ods, psu_considerations.ods, questions_list.ods, todo_list.ods, values.ods]
2018-05-12 Updated the flowchart and discussed issues in a meeting
    [expenses.ods]
2018-05-21 Updated expenses with Last School donation
    [expenses.ods]
2018-05-21 Added an FS transfer of 860 rs.
    [expenses.ods]
2018-06-03 Discussed how to proceed with the code and shifted the current version of the percentage function into the rough code. The arduino code in the octave folder is no longer maintained so we can now work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
    [arduino_implementation_not_maintained.ino]
2018-06-03 I added some error codes. The code still hasn't been tested, but it compiles.
    [rough.ino]
2018-08-02 Updated expenses
    [expenses.ods]
2019-06-11 Started update MULTIMETER class to use ADS1115 ADC module instead of Arduino inbuilt, moved menu class files to version_1.0 from rough
2019-06-13 Results of function test on battery
2019-06-15 More function tests and averaging and ovf fixes hopefully
    [MULTIMETER.cpp]
2019-06-15 Started work on version_1.0, minor fixes in DSP_MENU and added init_eeprom program
    [CODEDEFINITIONS.h, DSP_MENU.cpp, MULTIMETER.cpp, MULTIMETER.h, dsp_menu_menu_defs.h, init_eeprom.ino, version_1.0.ino]
2022-09-28 The charging curves are all ready, but they are all very inaccurate. I should probably split the upper half of the points from the lower half...
